mariusmym/ESP32-WROOM-32E-DevBoard/SCHEMATIC/Schematic_ESP32-WROOM-32E-DevBoard.png

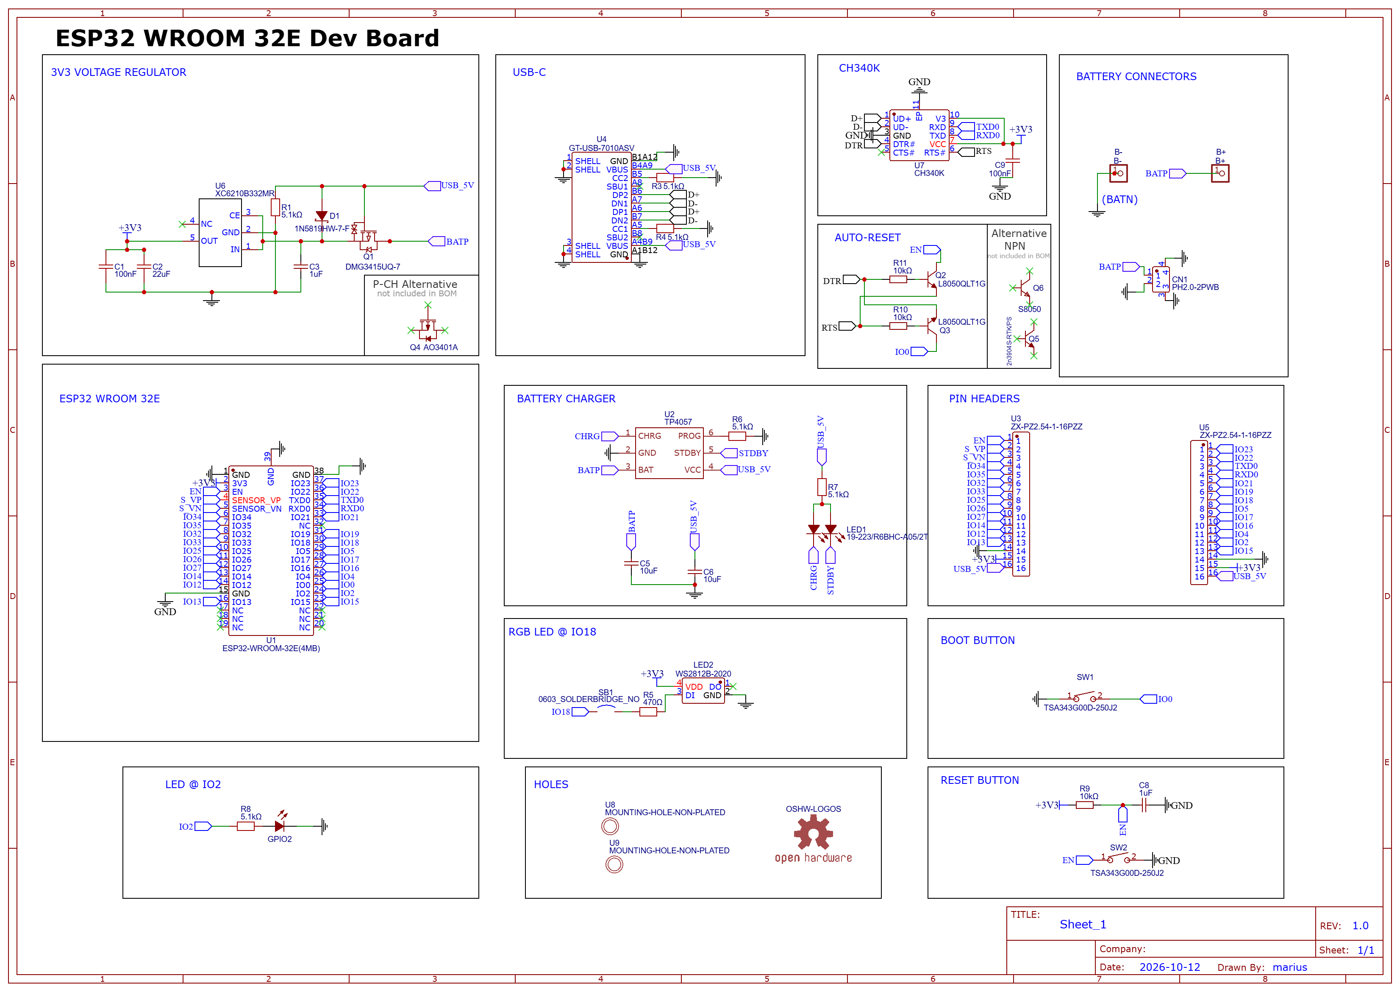
SCHEMATIC/Schematic_ESP32-WROOM-32E-DevBoard.png
