mariusmym/ESP32-WROOM-32E-DevBoard/GERBER, BOM, PNP/BOM_ESP32-WROOM-32E-DevBoard.csv

ID | Name | Designator | Footprint | Quantity | Manufacturer Part | Manufacturer | Supplier | Supplier Part
1 | ZX-PZ2.54-1-16PZZ | U5,U3 | HDR-TH_16P-P2.54-V-M-2 | 2 | ZX-PZ2.54-1-16PZZ | Megastar(兆星) | LCSC | C7501270
2 | 1N5819HW-7-F | D1 | SOD-123_L2.7-W1.6-LS3.7-RD | 1 | 1N5819HW-7-F | DIODES(美台) | LCSC | C82544
3 | DMG3415UQ-7 | Q1 | SOT-23-3_L2.9-W1.6-P1.90-LS2.8-BR | 1 | DMG3415UQ-7 | DIODES(美台) | LCSC | C459537
4 | 5.1kΩ | R7,R1,R3,R8 | R_0603_S | 4 | SCR0603J5K1 | VO(翔胜) | LCSC | C3017721
5 | CH340K | U7 | ESOP-10_L4.9-W3.9-P1.00-LS6.2-BL-EP_NO-CTS-PIN | 1 | CH340K | WCH(南京沁恒) | LCSC | C968586
6 | ESP32-WROOM-32E(4MB) | U1 | WIFI-SMD_ESP32-WROOM-32E-A-NO-PSRAM-PINS | 1 | ESP32-WROOM-32E-N4 | ESPRESSIF(乐鑫) | LCSC | C701341
7 | 100nF | C1 | C_0603_S | 1 | C0603X104M3RECAUTO | KEMET(基美) | LCSC | C2204461
8 | 22uF | C2 | C_0603_S | 1 | C0603X5R226M6R3NT | SANYEAR(叁叶源) | LCSC | C466783
9 | 1uF | C3 | C_0603_S | 1 | CC0603KRX5R7BB105 | YAGEO(国巨) | LCSC | C106215
10 | 10uF | C5,C6 | C_0603_S | 2 | CC0603MRX5R7BB106 | YAGEO(国巨) | LCSC | C109457
11 | 470Ω | R5 | R_0603_S | 1 | CR0603J470RP05Z | EVER OHMS(天二科技) | LCSC | C881198
12 | XC6210B332MR | U6 | SOT-23-5_L3.0-W1.7-P0.95-LS2.8-BR | 1 | XC6210B332MR-G | TOREX(特瑞仕) | LCSC | C47719
13 | 19-223/R6BHC-A05/2T | LED1 | LED-ARRAY-SMD_4P-L1.6-W1.3-BR-FD | 1 | 19-223/R6BHC-A05/2T | EVERLIGHT(亿光) | LCSC | C131286
14 | 1uF | C8 | C_0603_S | 1 | CL05A105KP5NNNC | SAMSUNG(三星) | LCSC | C14445
15 | 100nF | C9 | C_0603_S | 1 | CC0603KRX7R9BB104 | YAGEO(国巨) | LCSC | C14663
16 | L8050QLT1G | Q2,Q3 | SOT-23-3_L2.9-W1.3-P1.90-LS2.4-BR | 2 | L8050QLT1G | LRC | LCSC | C49581
17 | 10kΩ | R9 | R_0603_S | 1 | 0402WGF1002TCE | UNI-ROYAL(厚声) | LCSC | C25744
18 | 10kΩ | R10,R11 | R_0603_S | 2 | RC0603FR-0710KL | YAGEO(国巨) | LCSC | C98220
19 | TSA343G00D-250J2 | SW1,SW2 | SW-SMD_L4.0-W2.9-P4.15-EH | 2 | TSA343G00D-250J2 | BRIGHT(博瑞泰) | LCSC | C354947
20 | 19-213/Y2C-CQ2R2L/3T(CY) | GPIO2 | LED0603-R-RD | 1 | 19-213/Y2C-CQ2R2L/3T(CY) | EVERLIGHT | LCSC | C72038
21 | WS2812B-2020 | LED2 | LED-SMD_4P-L2.0-W2.0-TL_WS2812B-2020 | 1 | WS2812B-2020 | worldsemi | LCSC | C965555
22 | GT-USB-7010ASV | U4 | USB-C-SMD_G-SWITCH_GT-USB-7010ASV | 1 | GT-USB-7010ASV | G-Switch(品赞) | LCSC | C2988369
23 | TP4057 | U2 | SOT-23-6_L2.9-W1.6-P0.95-LS2.8-BL | 1 | TP4057-42-SOT26-R | TOPPOWER(南京拓微) | LCSC | C12044
24 | PH2.0-2PWB | CN1 | CONN-SMD_2P-P2.00_PH2.0-SPWB | 1 | PH-2P卧贴 | BOOMELE(博穆精密) | LCSC | C47647
25 | 5.1kΩ | R6,R4 | 0603 | 2 | SCR0603J5K1 | VO(翔胜) | LCSC | C3017721
